azerty220/usart_sans_fil_projet_esc2026_2027/avancee_seances.md

**Séance 1 :**

* cadre du projet fixé avec le client

* définition d'un chef de projet

* lecture des documentations existantes

* mise en place d'un outil de gestion d'information : GitHub

* mise en place d'un outil de messagerie : teams

* Comparaison des solutions proposées (BPSK à 2.44GHz, et ASK à 868MHz) : Avantages, Inconvénients

**Devoirs pour la séance 2 :**

Lire attentivement les documents et être apte à les comprendre

**Séance 2 :**

* Version de KiCad qui sera utilisée : 9.0
* Chaîne de fonctionnement du système établie
* Répartition du travail à faire, création des binômes, affiliation
* Création du planning et d'un diagramme de Gantt sur la globalité du projet

**Devoir pour la séance 3 :**

Trouver les composants nécessaire aux bloc affilié à notre binôme, afin de présenter un bilan de puissance par bloc.

On fera attention aux critères de gain, de prix, de pertes et de bruit thermique pour le choix des composants.

**Séance 3 :**

* Mise en commun des différents composants trouvés
* Statut sur la fréquence utilisée : 868.6MHz
* Commande de composants nécessaires passée : pour tout le projet (pcb suivant également) en prenant en compte les composants que nous avons déjà en stock

**Devoir pour la séance 4 :**

Prendre en compte que nous devons finir le routage du pcb la semaine prochaine et s'avancer sur le schématique en fonction du besoin.

**Séance 4 :**

* Finition des schématiques
* Avancée / Finitions du routage
* Prise en compte des composants passifs présents dans l'école : pour les dimensions pour l'empreinte notamment

**Devoir pour la séance 5 :**

Avoir fini le routage entre temps, l'avoir fait validé, et qu'il ait été envoyé pour construction.

En prévision de la séance 5 : rien !

**Séance 6 :**

* Protocole de test rédigé pour chaque PCB
* Schématique du PCB final fait

**Devoir pour la séance 7 :**

Avoir soudé le PCB et avoir effectué les tests afin de pouvoir modifié le routage du PCB final.

**Séance 7 :**

* écrire ici
