azerty220/usart_sans_fil_projet_esc2026_2027/images/ModASK_ADG918.png

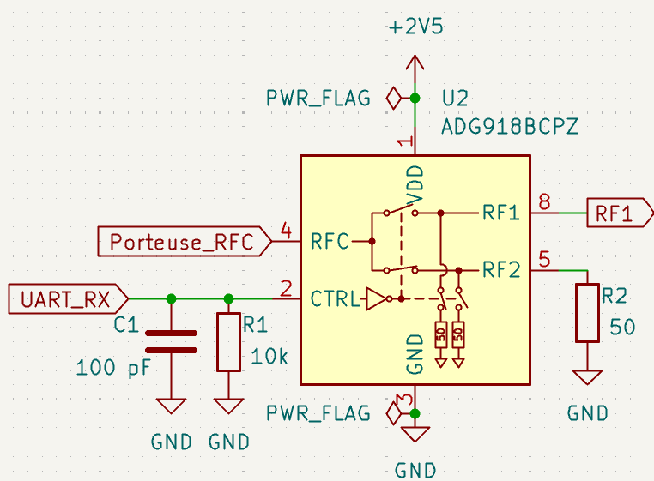
images/ModASK_ADG918.png
