azerty220/usart_sans_fil_projet_esc2026_2027/images/ModASK_PCB_KiCAD.png

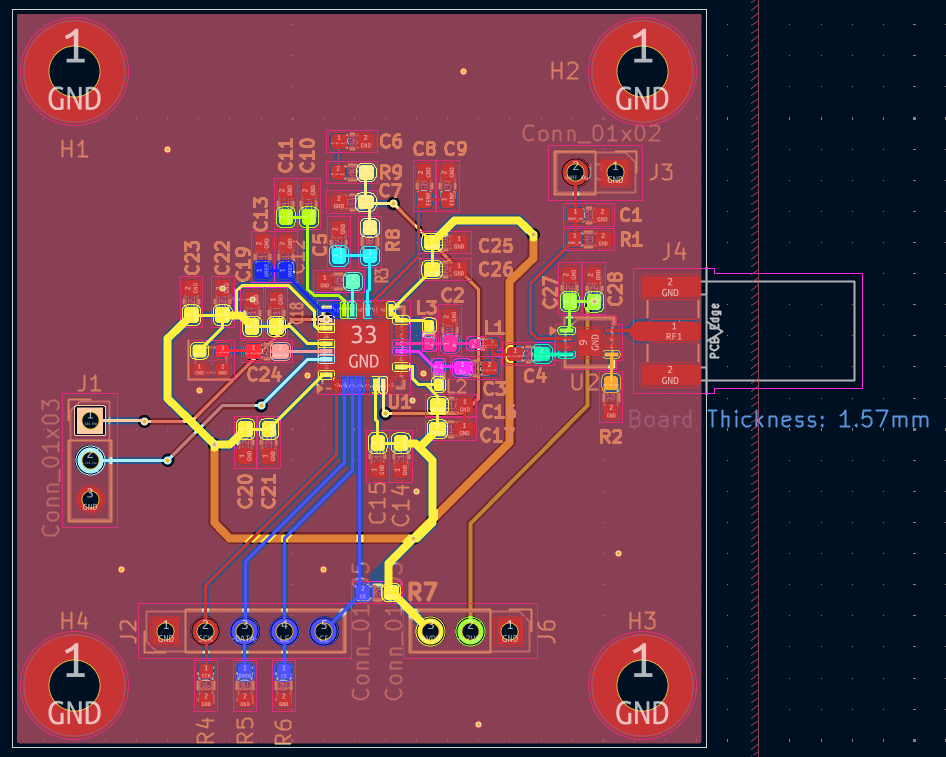
images/ModASK_PCB_KiCAD.png
