azerty220/usart_sans_fil_projet_esc2026_2027/images/ModASK_Table_balun_values.png

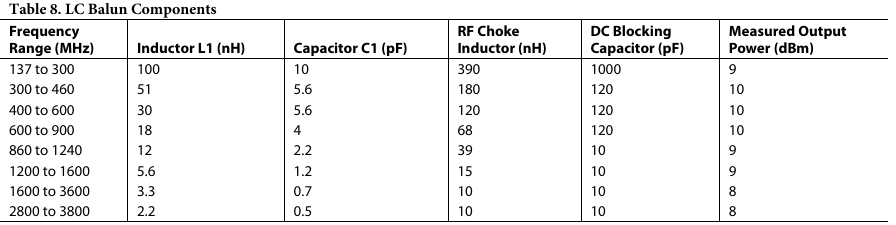
images/ModASK_Table_balun_values.png
