azerty220/usart_sans_fil_projet_esc2026_2027/images/ModASK_Vtune_Cpout.png

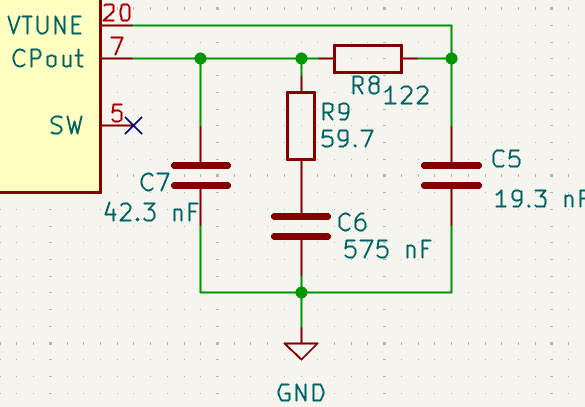
images/ModASK_Vtune_Cpout.png
