azerty220/usart_sans_fil_projet_esc2026_2027/images/Schéma simplifié du projet.png

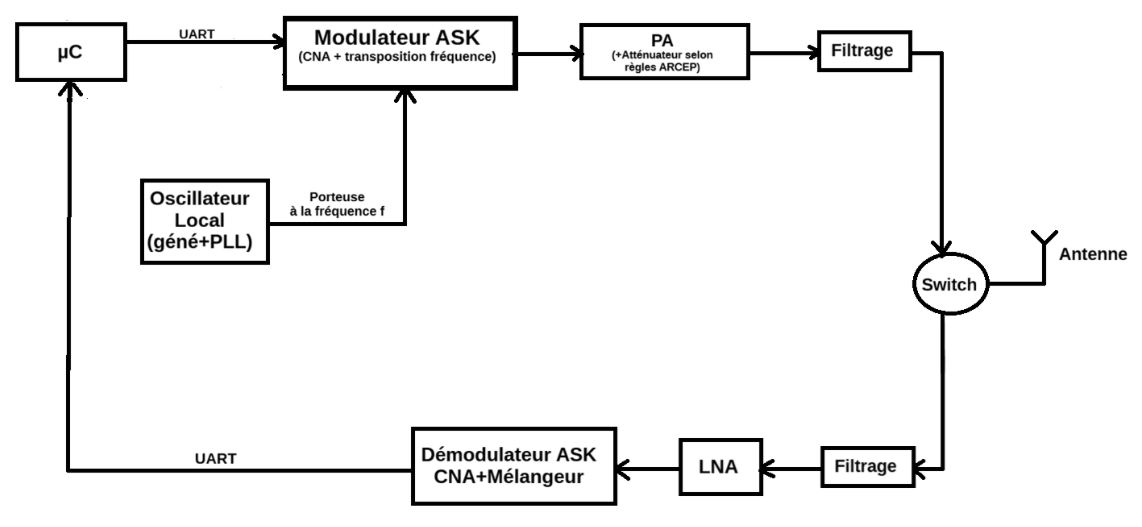
images/Schéma simplifié du projet.png
