azerty220/usart_sans_fil_projet_esc2026_2027/Compta.xlsx

Item | Détails | Quantité | Prix | Total | Commentaire
1. Commande composants | PLL+géné (OL) 584-ADF4350BCPZ | 1 | 18.83€ | 18.83€
 | Démodulateur 584-AD8313ARMZ-R | 1 | 23.32€ | 23.32€
 | Guerrilla RF GRF2070 | 3 | 2.30€ | 6.90€ |  | Budget alloué | 250€
 | Filtres passe bande SF2425E 868.6MHz 198-SF2425E | 5 | 1.16€ | 5.80€ |  | Total projet | 196.88€
 | Frais de port | 1 | 25€ | 25€ |  | Budget restant | 53.115€
 |  |  | Total Item 1 | 79.85€
2. Commande PCBs | PCB Mod ASK+PLL avec stencil | 1 | 9.9858 | 9.9858
 | PCB PA+Filtrage avec stencil | 1 | 10.0748 | 10.0748
 | PCB Switch+Antenne avec stencil | 1 | 9.9858 | 9.9858
 | PCB LNA+Filtrage avec stencil | 1 | 9.9858 | 9.9858
 | PCB Démodulateur avec stencil | 1 | 10.0748 | 10.0748
 | Frais de port | 2 | 33.464 | 66.928
 |  |  | Total Item 2 | 117.035
3. Commande PCB | PCB Final
 | Frais de port |  | 33.464
 |  |  | Total item 3 | 0
