azerty220/usart_sans_fil_projet_esc2026_2027/composants/liste_composants_projet.ods

Composant | Référence | Nb nécessaire | En stock / à commander | Binôme | Prix | Fournisseur | Lien
Machien magique | MMxxx999 | 1 | à commander | Johan / Awa | 0,00 € | Würth | https://magical-machine.com
Switch RF | PE42430MLAB-Z | 1 | En stock | Johan / Awa
antenne drone | 74889100921 | 1 | En stock | Johan / Awa
PLL+géné (OL) | ADF4350BCPZ | 1 | à commander | Julie / Maxence | 18,83 € | Mouser
Démodulateur | Ad8313 | 1 | à commander | Johan / Awa | 24,00 € | Mouser
Antenne PC (WIRL-ACCE HYDRA-1) | 2600130083 | 1 | à commander | Johan / Awa | 0,00 € | Würth
LNA | Guerrilla RF GRF2070 | 3 | à commander | Julie / Rafik | 2,30 € | Mouser
Filtres Passe-bande 868,6MHz | SF2425E / 198-SF2425E | 5 | à commander | Callum / Elise | 1,16 € | Mouser
