azerty220/usart_sans_fil_projet_esc2026_2027/composants/Liste des composants disponibles salle D283 - Feuille 1.ods

Fonction | Référence Fabricant | Lien Mouser | Quantité | Lien Wurth
Boucles à phase asservie - PLL F-N with high performance integrated VCO | ADF4350BCPZ | https://www.mouser.fr/fr/ProductDetail/Analog-Devices/ADF4350BCPZ?qs=BpaRKvA4VqGt2ZHwONikjQ%3D%3D | 1
Démodulateur - Détecteur RF uSOIC 0.1 TO 2.5GHz Détecteur RF/Cntrllr | AD831ARMZ | https://www.mouser.fr/fr/ProductDetail/Analog-Devices/AD8314ARMZ?qs=%2FtpEQrCGXCwYfXULcE%2FB2A%3D%3D | 1
Modulateur ASK - CI commutateurs RF 1GHz 2:1 MUX (50 Ohm Termination) I.C. | ADG918BCPZ-500RL7 | https://www.mouser.fr/fr/ProductDetail/Analog-Devices/ADG918BCPZ-500RL7?qs=BpaRKvA4VqFQVutXSJar%2FA%3D%3D | 5
VCO - Oscillateurs VCO Monolithic Voltage Controlled Oscillator | MAX2622EUA+ | https://www.mouser.fr/fr/ProductDetail/Analog-Devices-Maxim-Integrated/MAX2622EUA%2B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 | 2
Condensateurs céramique multicouches MLCC - CMS 2GHz-4GHz 100V S Band | BC08208408DXBAJ | https://www.mouser.fr/fr/ProductDetail/Vishay/BC08208408DXBAJ?qs=Znm5pLBrcAL97FjIapAbNw%3D%3D | 83
PA (Power Amplifier) - Amplificateur RF 851-894MHz Gn 36.5dB OP1dB 30.8dBm | SKY66185-11 | https://www.mouser.fr/fr/ProductDetail/Skyworks-Solutions-Inc/SKY66185-11?qs=VxEzYtM1yldMn8MAOsOp7g%3D%3D | 2
Antenne - ANTENNA 2.4GHZ CORNER 140MM SMA | AMB1926 | https://www.mouser.be/fr/ProductDetail/Wurth-Elektronik/2600130021 (https://www.mouser.fr/fr/ProductDetail/Skyworks-Solutions-Inc/SKY66185-11?qs=VxEzYtM1yldMn8MAOsOp7g%3D%3D) | 1 | https://www.digikey.fr/en/products/detail/w%C3%BCrth-elektronik/AMB1926/8258139
Atténuateur - RF Attenuators 6dB 0 Hz ~ 3 GHz 50 Ohms 125mW 1206 (3216 Metric) | PAT1632-C-6DB-T1 | https://www.mouser.fr/fr/ProductDetail/Susumu/PAT1632-C-6DB-T1?qs=wnTfsH77Xs6rJxxbm0fa2w%3D%3D | 3 | https://www.digikey.fr/en/products/detail/susumu/PAT1632-C-6DB-T1/5975823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
PA (Power Amplifier) - Amplificateur RF .1-6.0GHz InGaP HBT Sm Sig Gain 16dB | SKY65014-70LF | https://www.mouser.fr/fr/ProductDetail/Skyworks-Solutions-Inc/SKY65014-70LF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 | 4
LNA - Amplificateur RF 0.6-4.2 GHz Ultra-LNA | QPL9057TR7 | https://www.mouser.fr/fr/ProductDetail/Qorvo/QPL9057TR7?qs=PqoDHHvF648aNfv0Ctpg5A%3D%3D | 4
OL - Oscillateurs VCO VCO SMT w/Buffer amp, 2.25 - 2.5 GHz | HMC385LP4ETR | https://www.mouser.fr/fr/ProductDetail/Analog-Devices/HMC385LP4ETR?qs=pceeu5JH%2FH%2FWo0fp8A7gpg%3D%3D | 4
MIX - Mixage RF DBL BAL MIX / SURF MT / RoHS | ADE-3G+ | https://www.mouser.fr/fr/ProductDetail/Mini-Circuits/ADE-3G%2b?qs=xZ%2FP%252Ba9zWqaih72O7p1wPA%3D%3D | 4
OL - Oscillateurs VCO 2400-2400MHz -40C to 85C | CVCO55CC-2400-2400 | https://www.mouser.fr/fr/ProductDetail/Crystek-Corporation/CVCO55CC-2400-2400?qs=4zFPArRKzl55cc50XS6Y7Q%3D%3D | 4
3.0V to 5.5 V - Circuit intégré d'interface RS-232 3.0V to 5.5V, Low-Power, up to 1Mbps, Tr | MAX3232ESE+T | https://www.mouser.fr/fr/ProductDetail/Analog-Devices-Maxim-Integrated/MAX3232ESE%2BT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 | 10
Filtre - Conditionnement de signaux 1.4 mm x 1.1 mm - 20 C to + 75 C 2.44175 GHz 2 dB 83.5 MHz 3.5 V 50 Ohms | B39242B9413K610 | https://www.mouser.fr/fr/ProductDetail/RF360/B39242B9413K610?qs=AKDv8POSxR1xnWOVVPKw7A%3D%3D | 7
Condensateurs céramique multicouches MLC - Condensateurs céramique multicouches MLCC - CMS 0.047 uF 630 VDC 10% 1210 X7T | GR332DD72J473KW01L | https://www.mouser.fr/fr/ProductDetail/Murata-Electronics/GR332DD72J473KW01L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 | 10
Filtre - Conditionnement de signaux DBP.868.U.A.30 Dielectric Band Pass Filter for 868MHz | DBP.868.U.A.30 | https://www.mouser.fr/fr/ProductDetail/Taoglas/DBP.868.U.A.30?qs=MLItCLRbWsxZm5scDvQavg%3D%3D | 1
Atténuateur | HMC346AMS8GETR | https://www.mouser.fr/fr/ProductDetail/Analog-Devices/HMC346AMS8GETR?qs=5aG0NVq1C4wB%2Fd11tx7%252Bpw%3D%3D | 2
Quartz 26MHz - Oscillateurs TCXO MultiVolt TCXO,26MHz,+/-500ppb,1.7V 3.465V,2.0 mA,-30 C 85 C, 2.00mm x 1.60mm | ECS-TXO-20CSMV-AC-260-AY-TR | https://www.mouser.fr/fr/ProductDetail/ECS/ECS-TXO-20CSMV-260-AY-TR?qs=Cb2nCFKsA8q4u1W%252BdBvDzQ%3D%3D | 3
Quartz 25MHz - Oscillateurs TCXO XTAL OSC TCXO 25MHz CMOS | ATX-H11-F-25.000MHz-F25-T | https://www.mouser.fr/fr/ProductDetail/ABRACON/ATX-H11-F-25.000MHz-F25-T?qs=vvQtp7zwQdNp90v3eF%2F7eg%3D%3D | 4
Switch - CI commutateurs RF DC-3.0GHz ISO 22dB IL <.3dB @ 2.4GHz | MASWSS0115TR-3000 | https://www.mouser.fr/fr/ProductDetail/MACOM/MASWSS0115TR-3000?qs=3Wmz%2FrCSAaEflvnPFG8Leg%3D%3D | 4
Module - Émetteur-récepteur RF Low-Power Sub-1GHz R F Transceiver A 595 A 595-CC1101RGPR | CC1101RGP | https://www.mouser.fr/fr/ProductDetail/Texas-Instruments/CC1101RGP?qs=OHhYoCux73laNhcVQ4PFrw%3D%3D | 2
Résistances ajustables - SMD 4mm 10Kohms 10% Square Cermet Sealed | 3224W-1-103G | https://www.mouser.fr/fr/ProductDetail/Bourns/3224W-1-103G?qs=tEaODSGlU8MrZGpCN6zqBQ%3D%3D | 2
Switch - CI commutateurs RF SP3T, Low IL, Reflective, 50ohm RF Switch | PE42430MLAB-Z | https://www.mouser.fr/fr/ProductDetail/pSemi/PE42430MLAB-Z?qs=iw0hurA%2FaD37L0LfLBRi4Q%3D%3D | 4
LNA - Amplificateur RF Low Noise Amplifier 0.15 - 6 GHz | MAAL-011207-TR3000 | https://www.mouser.fr/fr/ProductDetail/MACOM/MAAL-011207-TR3000?qs=rQFj71Wb1eUM1YfhtamsxQ%3D%3D | 3
Inducteurs RF - CMS IFCB-0402 .0082 3.7% ER E3 | IFCB0402ER8N2S | https://www.mouser.com/ProductDetail/Vishay-Dale/IFCB0402ER8N2S?qs=IFXZK9YKOtYBs1cy8OBmcA%3D%3D | 49
Inducteurs RF - CMS 1005 140nH Unshld 5% 630mA 260mOhms | 0402AF-141XJLW | https://www.mouser.fr/fr/ProductDetail/Coilcraft/0402AF-141XJLW?qs=JVZp5BaCFzgnytl%252BpX4NdQ%3D%3D | 9
Antenne Céramique - WE-MCA Multilayer Chip Antenna | 7488960245 |  | 1 | https://www.we-online.com/en/components/products/WE-MCA?sq=7488960245#7488960245
Inductance - WE-KI SMT Wire Wound Ceramic Inductor | 744761211A |  | 20 | https://www.we-online.com/en/components/products/WE-KI?sq=744761211A#744761211A
