azerty220/usart_sans_fil_projet_esc2026_2027/composants/commande_composant.ods

Sheet: Mouser
Mouser |  |  |  |  | Envoyez un seul fichier par mail!
Pos | I | P | Art | Désignation | Qté commandée | UA | Date Livraison | Prix unitaire | Devise | Q | Grpe | Div
10 | Z |  |  | PLL+géné (OL) 584-ADF4350BCPZ | 1 | PC | 16.10.2026 | 18.83 | EUR | PC | TA.01
20 | Z |  |  | Démodulateur 584-AD8313ARMZ-R | 1 | PC | 16.10.2026 | 23.32 | EUR | PC | TA.01
30 | Z |  |  | Frais de port | 1 | PC | 16.10.2026 | 25.00 | EUR | PC | TA.01
40 | Z |  |  | Guerrilla RF GRF2070 | 3 | PC | 16.10.2026 | 2.30 | EUR | PC | TA.01
50 | Z |  |  | Filtres passe bande SF2425E 868.6MHz 198-SF2425E | 5 | PC | 16.10.2026 | 1.16 | EUR | PC | TA.01
60 | Z |  |  |  |  | PC |  |  | EUR | PC | TA.01
70 | Z |  |  |  |  | PC |  |  | EUR | PC | TA.01
80 | Z |  |  |  |  | PC |  |  | EUR | PC | TA.01
90 | Z |  |  |  |  | PC |  |  | EUR | PC | TA.01
100 | Z |  |  |  |  | PC |  |  | EUR | PC | TA.01
110 | Z |  |  |  |  | PC |  |  | EUR | PC | TA.01
120 | Z |  |  |  |  | PC |  |  | EUR | PC | TA.01
130 | Z |  |  |  |  | PC |  |  | EUR | PC | TA.01
140 | Z |  |  |  |  | PC |  |  | EUR | PC | TA.01
150 | Z |  |  |  |  | PC |  |  | EUR | PC | TA.01
160 | Z |  |  |  |  | PC |  |  | EUR | PC | TA.01
170 | Z |  |  |  |  | PC |  |  | EUR | PC | TA.01
180 | Z |  |  |  |  | PC |  |  | EUR | PC | TA.01
190 | Z |  |  |  |  | PC |  |  | EUR | PC | TA.01
MODE d'EMPLOI et CODE erreurs Version 19
1: indiquez le fournisseur ligne 1
2:remplissez pour chaque ligne commandée les 4 champs en rouge selon les règles suivantes:
 | Art
 |  |  | 2.1 | Ne mettez rien ici tout comme dans P: remplissez les zones rouges (et pas ailleurs)
 | Désignation
 |  |  | 2.2 | Ne dépassez pas les 40 caractères: il seront automatiquement effacés lors de la recopie
 |  |  | 2.3 | Mettre une courte descritption suiivi du code commande du fournisseur
 |  |  | 2.4 | Pour RS et Farnell : mettre le code commande RS ou Farnell (7 à 9 chiffres) (et pas la référence constructeur) après la courte description
 |  |  | 2.5 | Exemple: Condensateur 1uF 0805 125-4857
 | Qté commandée
 |  |  | 2.6 | C'est le nombre d'unités correspondant au prix unitaire
 |  |  | 2.7 | Attention il y a des pièges
 |  |  | 2.8 | avec RS par exemple on vous demande parfois de commander par lot de 5 par exemple
 |  |  | 2.9 | si vous commandez 1 lot : le nombre d'unité est alors 5 pour 1 lot et non 1
 | date
 |  |  | 2.10 | Pour la date: mettre la de date dans une semaine
 |  |  | 2.11 | La mettre au format JJ.MM.AAAA
 |  |  | 2.13 | Bien utiliser les points comme séparateur
 | prix unitaire
 |  |  | 2.14 | Le prix est le prix HT (sans la TVA 20%) en euros d'une unité
 |  |  | 2.15 | arrondi au centime supérieur (0.012 euros devient 0.02!)
 |  |  | 2.16 | avec pour séparateur le point
 |  |  | 2.17 | n'utilisez pas le symbole euros d'excel
3: frais de port
 |  |  | 3.1 | ajoutez une ligne pour les frais de port
 |  |  | 3.2 | dont la désignation est "frais de port"
 |  |  | 3.3 | pas de frais de port à mettre pour RS ou Farnell
 |  |  | 3.4 | Renseignez vous pour connaître les frais de port
4: conseils complémentaires
 |  |  | 4.1 | Ne modifier que les 4 champs en rouge
 |  |  | 4.2 | Ne pas modifier le document sinon cela n'a plus aucun intérêt
 |  |  | 4.3 | Mettez les références dans le même ordre que celui de la commande
 |  |  | 4.4 | Vérifier bien sur les sites les références et les prix!
 |  |  | 4.5 | N'oubliez pas les frais de port!: ajoutez une ligne pour les mentionner
5: sauvegardez le fichier au format xls

Sheet: Würth
Würth |  |  |  |  | Envoyez un seul fichier par mail!
Pos | I | P | Art | Désignation | Qté commandée | UA | Date Livraison | Prix unitaire | Devise | Q | Grpe | Div
10 | Z |  |  | Antenne(WIRL-ACCE HYDRA-1) 2600130083 | 1 | PC | 16.10.2026 | 0.00 | EUR | PC | TA.01
20 | Z |  |  |  |  | PC |  |  | EUR | PC | TA.01
30 | Z |  |  |  |  | PC |  |  | EUR | PC | TA.01
40 | Z |  |  |  |  | PC |  |  | EUR | PC | TA.01
50 | Z |  |  |  |  | PC |  |  | EUR | PC | TA.01
60 | Z |  |  |  |  | PC |  |  | EUR | PC | TA.01
70 | Z |  |  |  |  | PC |  |  | EUR | PC | TA.01
80 | Z |  |  |  |  | PC |  |  | EUR | PC | TA.01
90 | Z |  |  |  |  | PC |  |  | EUR | PC | TA.01
100 | Z |  |  |  |  | PC |  |  | EUR | PC | TA.01
110 | Z |  |  |  |  | PC |  |  | EUR | PC | TA.01
120 | Z |  |  |  |  | PC |  |  | EUR | PC | TA.01
130 | Z |  |  |  |  | PC |  |  | EUR | PC | TA.01
140 | Z |  |  |  |  | PC |  |  | EUR | PC | TA.01
150 | Z |  |  |  |  | PC |  |  | EUR | PC | TA.01
160 | Z |  |  |  |  | PC |  |  | EUR | PC | TA.01
170 | Z |  |  |  |  | PC |  |  | EUR | PC | TA.01
180 | Z |  |  |  |  | PC |  |  | EUR | PC | TA.01
190 | Z |  |  |  |  | PC |  |  | EUR | PC | TA.01
MODE d'EMPLOI et CODE erreurs Version 19
1: indiquez le fournisseur ligne 1
2:remplissez pour chaque ligne commandée les 4 champs en rouge selon les règles suivantes:
 | Art
 |  |  | 2.1 | Ne mettez rien ici tout comme dans P: remplissez les zones rouges (et pas ailleurs)
 | Désignation
 |  |  | 2.2 | Ne dépassez pas les 40 caractères: il seront automatiquement effacés lors de la recopie
 |  |  | 2.3 | Mettre une courte descritption suiivi du code commande du fournisseur
 |  |  | 2.4 | Pour RS et Farnell : mettre le code commande RS ou Farnell (7 à 9 chiffres) (et pas la référence constructeur) après la courte description
 |  |  | 2.5 | Exemple: Condensateur 1uF 0805 125-4857
 | Qté commandée
 |  |  | 2.6 | C'est le nombre d'unités correspondant au prix unitaire
 |  |  | 2.7 | Attention il y a des pièges
 |  |  | 2.8 | avec RS par exemple on vous demande parfois de commander par lot de 5 par exemple
 |  |  | 2.9 | si vous commandez 1 lot : le nombre d'unité est alors 5 pour 1 lot et non 1
 | date
 |  |  | 2.10 | Pour la date: mettre la de date dans une semaine
 |  |  | 2.11 | La mettre au format JJ.MM.AAAA
 |  |  | 2.13 | Bien utiliser les points comme séparateur
 | prix unitaire
 |  |  | 2.14 | Le prix est le prix HT (sans la TVA 20%) en euros d'une unité
 |  |  | 2.15 | arrondi au centime supérieur (0.012 euros devient 0.02!)
 |  |  | 2.16 | avec pour séparateur le point
 |  |  | 2.17 | n'utilisez pas le symbole euros d'excel
3: frais de port
 |  |  | 3.1 | ajoutez une ligne pour les frais de port
 |  |  | 3.2 | dont la désignation est "frais de port"
 |  |  | 3.3 | pas de frais de port à mettre pour RS ou Farnell
 |  |  | 3.4 | Renseignez vous pour connaître les frais de port
4: conseils complémentaires
 |  |  | 4.1 | Ne modifier que les 4 champs en rouge
 |  |  | 4.2 | Ne pas modifier le document sinon cela n'a plus aucun intérêt
 |  |  | 4.3 | Mettez les références dans le même ordre que celui de la commande
 |  |  | 4.4 | Vérifier bien sur les sites les références et les prix!
 |  |  | 4.5 | N'oubliez pas les frais de port!: ajoutez une ligne pour les mentionner
5: sauvegardez le fichier au format xls
