azerty220/usart_sans_fil_projet_esc2026_2027/PCB2/gros_pcb_commun/gros_pcb_commun.kicad_pcb

## KiCad design PCB2/gros_pcb_commun/gros_pcb_commun.kicad_pcb (2026-11-12)

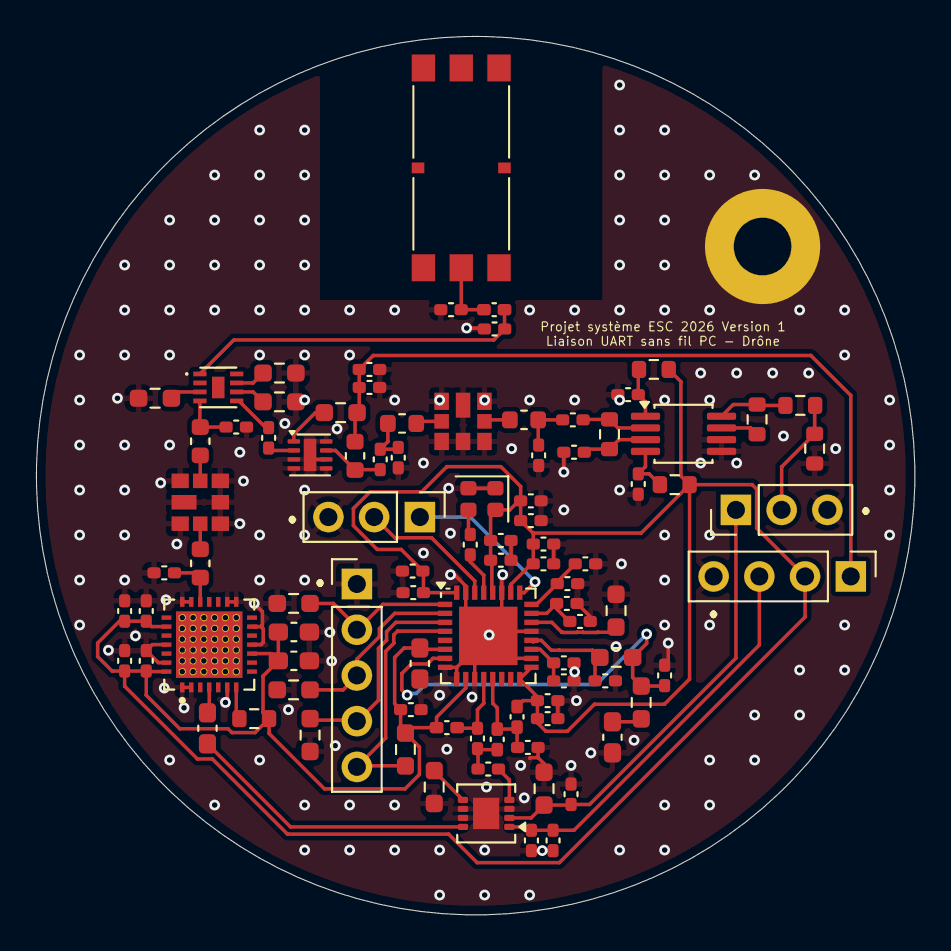
[picture p59: board gros_pcb_commun.kicad_pcb from above]

Board: 2 copper layers, 48.8 x 48.8 mm, 93 parts (0 on the bottom side), 52 nets.

Parts:
AE1: Antenna; AE_Wurth_WE-MCA_7488910092
C1, C3, C5, C7, C9: 100 nF; C_0402_1005Metric_Pad0.74x0.62mm_HandSolder
C2, C4, C6, C10, C13, C15, C17, C27: 10 pF; C_0402_1005Metric_Pad0.74x0.62mm_HandSolder
C8: 10 pF; C_0603_1608Metric_Pad1.08x0.95mm_HandSolder
C11: 1 uF; C_0402_1005Metric_Pad0.74x0.62mm_HandSolder
C12, C14, C16, C18, C28, C42, C43: 0.1 uF; C_0402_1005Metric_Pad0.74x0.62mm_HandSolder
C19: 1 nF; C_0402_1005Metric_Pad0.74x0.62mm_HandSolder
C20, C21: 4 nF; C_0402_1005Metric_Pad0.74x0.62mm_HandSolder
C22: 120 pF; C_0402_1005Metric_Pad0.74x0.62mm_HandSolder
C23: 42.3 nF; C_0402_1005Metric_Pad0.74x0.62mm_HandSolder
C24: 575 nF; C_0603_1608Metric_Pad1.08x0.95mm_HandSolder
C25: 19.3 nF; C_0402_1005Metric_Pad0.74x0.62mm_HandSolder
C26: 100 pF; C_0402_1005Metric_Pad0.74x0.62mm_HandSolder
C29, C32, C35, C36: 0.1u; C_0402_1005Metric_Pad0.74x0.62mm_HandSolder
C30: 2.7p; C_0402_1005Metric_Pad0.74x0.62mm_HandSolder
C31: 33p; C_0603_1608Metric_Pad1.08x0.95mm_HandSolder
C33, C37: 10u; C_0603_1608Metric_Pad1.08x0.95mm_HandSolder
C34: 3.5p; C_0402_1005Metric_Pad0.74x0.62mm_HandSolder
C38: 3.9pF; C_0402_1005Metric_Pad0.74x0.62mm_HandSolder
C39: 3.3pF; C_0402_1005Metric_Pad0.74x0.62mm_HandSolder
C40, C41: 680 pF; C_0402_1005Metric_Pad0.74x0.62mm_HandSolder
C44: 47pF; C_0402_1005Metric_Pad0.74x0.62mm_HandSolder
C45: 4.7pF; C_0402_1005Metric_Pad0.74x0.62mm_HandSolder
C46: 100nF; C_0402_1005Metric_Pad0.74x0.62mm_HandSolder
C47: 100pF; C_0402_1005Metric_Pad0.74x0.62mm_HandSolder
C48: 2,7pF; C_0402_1005Metric_Pad0.74x0.62mm_HandSolder
C49: 3,5pF; C_0402_1005Metric_Pad0.74x0.62mm_HandSolder
FL1: SF2425E
H3: MountingHole_Pad; MountingHole_3.2mm_M3_Pad
J1: Conn_01x03_Pin; PinHeader_1x03_P2.54mm_Vertical
J2: Conn_01x04_Pin; PinHeader_1x04_P2.54mm_Vertical
J3: Conn_01x05; PinHeader_1x05_P2.54mm_Vertical
J4: Conn_01x03; PinHeader_1x03_P2.54mm_Vertical
L1: 68 nH; L_0402_1005Metric_Pad0.77x0.64mm_HandSolder
L2, L3: 18 nH; L_0402_1005Metric_Pad0.77x0.64mm_HandSolder
L4, L5: 24n; L_0603_1608Metric
L6: 12nH; L_0402_1005Metric_Pad0.77x0.64mm_HandSolder
L7, L8, L9: 22nH; L_0603_1608Metric
R1, R2, R3, R5, R8, R11, R12, R13: 10k; R_0603_1608Metric_Pad0.98x0.95mm_HandSolder
R4: 5.1 k; R_0603_1608Metric_Pad0.98x0.95mm_HandSolder
R6: 59.7; R_0603_1608Metric_Pad0.98x0.95mm_HandSolder
R7: 122; R_0603_1608Metric_Pad0.98x0.95mm_HandSolder
R9: 50; R_0603_1608Metric_Pad0.98x0.95mm_HandSolder
R10: 5k1; R_0603_1608Metric
R14, R17: 10; R_0603_1608Metric
R15: 53,6; R_0603_1608Metric
R16: 0; R_0603_1608Metric
R18: 910; R_0603_1608Metric_Pad0.98x0.95mm_HandSolder
RL1: 1M; R_0603_1608Metric
Rprot1: 500; R_0603_1608Metric
SF1: SF2425E
U1: ADF4350; LFCSP-32-1EP_5x5mm_P0.5mm_EP3.25x3.25mm
U2: ADG918BCPZ; LFCSP-8-1EP_3x3mm_P0.5mm_EP1.45x1.74mm
U3: SKY66185-11; IC_SKY66185-11
U4: SON50P200X200X60-9N160X90
U5: AD8313xRM; MSOP-8_3x3mm_P0.65mm
U6: GRF2070; DFN-8-2x2mm_P0.7mm
Y1: ECS-TXO-20CSMV-AC-260-AY-TR; Oscillator_SMD_SiT_PQFN-4Pin_2.0x1.6mm

Connections:
+2V5: C27.1, C28.1, J2.3, U2.1 (VDD)
+5V: C46.1, C47.1, J2.1, L7.1, R18.1
A+: C20.1, L2.2, U1.12 (RF_OUT_A+)
A-: C21.1, L1.2, L3.2, U1.13 (RF_OUT_A-)
AVDD: C1.2, C2.2, C3.2, C4.2, C5.2, C6.2, C7.2, C8.2, C9.2, C10.2, C11.1, C12.1, C29.2, C32.2, C33.2, C35.1, C36.1, C37.1, J2.2, L1.1, L2.1, R2.1, R10.1, R14.1, R17.2, U1.6 (Vp), U1.10 (AVDD), U1.16 (VVCO), U1.17 (VVCO), U1.26 (PDB_RF), U1.28 (DVDD), U1.32 (SDVDD), U3.10 (VBIAS), U3.23 (VCC3), U3.28 (VCC1), Y1.4 (VDD)
CE: J3.5, R2.2, U1.4 (CE)
DATA: J3.3, R3.1, U1.2 (DATA)
FiltreIN: C30.1, L4.1, U3.19 (RFOUT)
GND: C1.1, C2.1, C3.1, C4.1, C5.1, C6.1, C7.1, C8.1, C9.1, C10.1, C11.2, C12.2, C13.2, C14.2, C15.2, C16.2, C17.2, C18.2, C21.2, C23.2, C24.2, C25.2, C26.2, C27.2, C28.2, C29.1, C30.2, C32.1, C33.1, C34.2, C35.2, C36.2, C37.2, C38.2, C39.2, C41.1, C42.2, C43.1, C46.2, C47.2, C48.2, C49.1, FL1.1 (IN_GND), FL1.3 (GND), FL1.4 (GND), FL1.5 (OUT_GND), FL1.7 (GND), FL1.8 (GND), H3.1, J1.3, J2.4, J3.1, J4.3, R1.2, R3.2, R4.1, R5.2, R8.2, R9.2, R11.2, R12.2, R13.2, RL1.1, SF1.1 (IN_GND), SF1.3 (GND), SF1.4 (GND), SF1.5 (OUT_GND), SF1.7 (GND), SF1.8 (GND), U1.8 (CPGND), U1.9 (AGND), U1.11 (AGNDVCO), U1.18 (AGNDVCO), U1.21 (AGNDVCO), U1.27 (DGND), U1.31 (SDGND), U1.33 (EP), U2.3 (GND), U2.6 (GND), U2.7 (GND), U2.9 (GND), U3.1 (GND), U3.2 (GND), U3.6 (GND), U3.11 (GND), U3.13 (GND), U3.15 (GND), U3.16 (GND), U3.20 (GND), U3.21 (GND), U3.25 (GND), U3.27 (GND), U5.5 (PWDN), U5.6 (COMM), U6.3 (GND), U6.4 (GND), U6.5 (GND), U6.6 (GND), U6.8 (GND), U6.9 (EP), Y1.1 (GROUND_1), Y1.2 (GROUND_2)
LE: J3.4, R1.1, U1.3 (LE)
unnamed: AE1.2 (A), C39.1, L6.2
unnamed: C20.2, C22.1, L3.1
unnamed: C24.1, R6.2
unnamed: C42.1, R14.2, U5.1 (VPOS)
unnamed: C43.2, R17.1, U5.4 (VPOS)
unnamed: C45.2, C48.1, L8.1
unnamed: FL1.2 (IN), L8.2
unnamed: FL1.6 (OUT), L9.1
unnamed: J4.1, U1.25 (LD)
unnamed: J4.2, U1.30 (MUXOUT)
unnamed: L4.2, SF1.2 (IN)
unnamed: L5.1, SF1.6 (OUT)
unnamed: C23.1, R6.1, R7.2, U1.7 (CPout)
unnamed: R4.2, U1.22 (RSET)
unnamed: C25.1, R7.1, U1.20 (VTUNE)
unnamed: R9.1, U2.5 (RF2)
unnamed: C31.2, U3.4 (RFIN)
unnamed: R10.2, U3.7 (~VEN)
unnamed: C38.1, L6.1, U4.1 (RFC)
unnamed: R11.1, U4.3 (V1)
unnamed: R12.1, U4.6 (V2)
unnamed: R13.1, U4.7 (V3)
unnamed: C40.2, R15.1, U5.2 (INHI)
unnamed: C41.2, R15.2, U5.3 (INLO)
unnamed: R16.1, Rprot1.1, U5.8 (VOUT)
unnamed: R16.2, U5.7 (VSET)
unnamed: C44.2, U6.2 (RF_IN)
unnamed: C45.1, L7.2, U6.7 (RF_OUT/VDD)
unnamed: R18.2, U6.1 (VENABLE)
unnamed: C19.1, Y1.3 (OUTPUT)
Porteuse_RFC: C22.2, U2.4 (RFC)
REFIN: C19.2, U1.29 (REFIN)
SCK: J3.2, R5.1, U1.1 (CLK)
TEMP: C13.1, C14.1, U1.19 (TEMP)
VCOM: C15.1, C16.1, U1.23 (VCOM)
VREF: C17.1, C18.1, U1.24 (VREF)
sig0: C26.1, J1.1, R8.1, U2.2 (CTRL)
sig1: C31.1, U2.8 (RF1)
sig2: C34.1, L5.2, U4.4 (RF1)
sig3: C44.1, U4.5 (RF2)
sig4: C40.1, C49.2, L9.2
sig5: J1.2, RL1.2, Rprot1.2
