azerty220/usart_sans_fil_projet_esc2026_2027/PCB1/LNA_Filtre/V9.0/LNA_GRF2070.kicad_pcb

## KiCad design PCB1/LNA_Filtre/V9.0/LNA_GRF2070.kicad_pcb (2026-10-22)

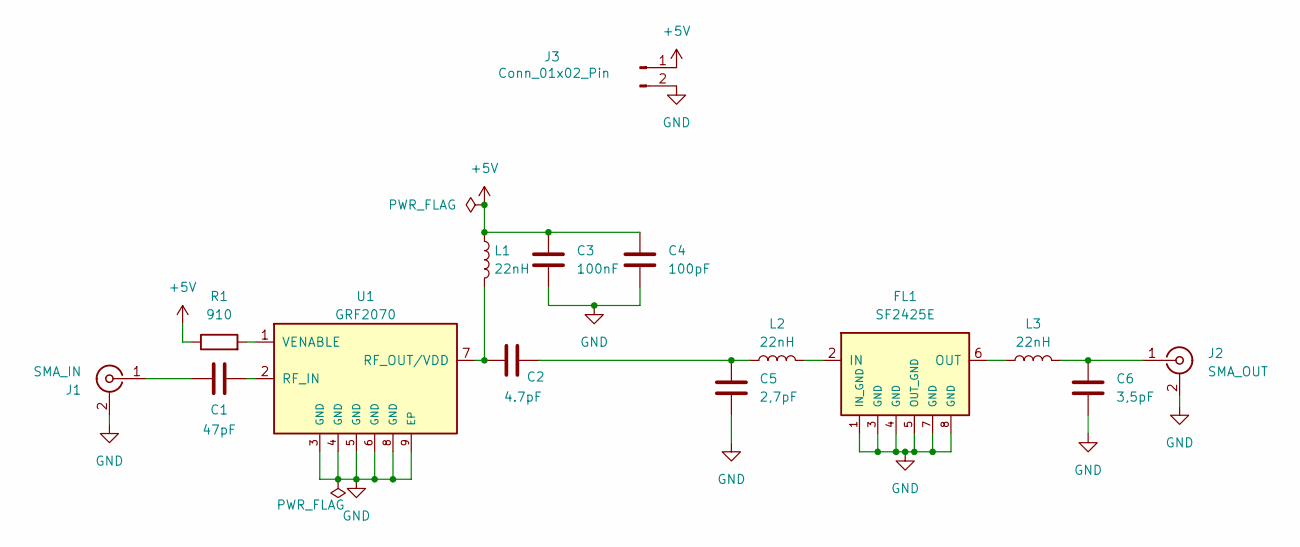
[picture p60: schematic LNA_GRF2070.kicad_sch]

Parts:
C1: 47pF; C_0603_1608Metric
C2: 4.7pF; C_0603_1608Metric
C3: 100nF; C_0603_1608Metric
C4: 100pF; C_0603_1608Metric
C5: 2,7pF; C_0603_1608Metric
C6: 3,5pF; C_0603_1608Metric
FL1: SF2425E
J1: SMA_IN; SMA_Samtec_SMA-J-P-H-ST-EM1_EdgeMount
J2: SMA_OUT; SMA_Samtec_SMA-J-P-H-ST-EM1_EdgeMount
J3: Conn_01x02_Pin; PinHeader_1x02_P2.54mm_Vertical
L1, L2, L3: 22nH; L_0603_1608Metric
R1: 910; R_0603_1608Metric_Pad0.98x0.95mm_HandSolder
U1: GRF2070; WDFN-8-1EP_2x2.2mm_P0.5mm_EP0.80x0.54

Connections:
+5V: C3.1, C4.1, J3.1, L1.1, R1.1
GND: C3.2, C4.2, C5.2, C6.1, FL1.1 (IN_GND), FL1.3 (GND), FL1.4 (GND), FL1.5 (OUT_GND), FL1.7 (GND), FL1.8 (GND), J1.2 (Ext), J2.2 (Ext), J3.2, U1.3 (GND), U1.4 (GND), U1.5 (GND), U1.6 (GND), U1.8 (GND), U1.9 (EP)
unnamed: C2.2, C5.1, L2.1
unnamed: FL1.2 (IN), L2.2
unnamed: FL1.6 (OUT), L3.1
unnamed: C1.1, J1.1 (In)
unnamed: C6.2, J2.1 (In), L3.2
unnamed: C1.2, U1.2 (RF_IN)
unnamed: C2.1, L1.2, U1.7 (RF_OUT/VDD)
unnamed: R1.2, U1.1 (VENABLE)

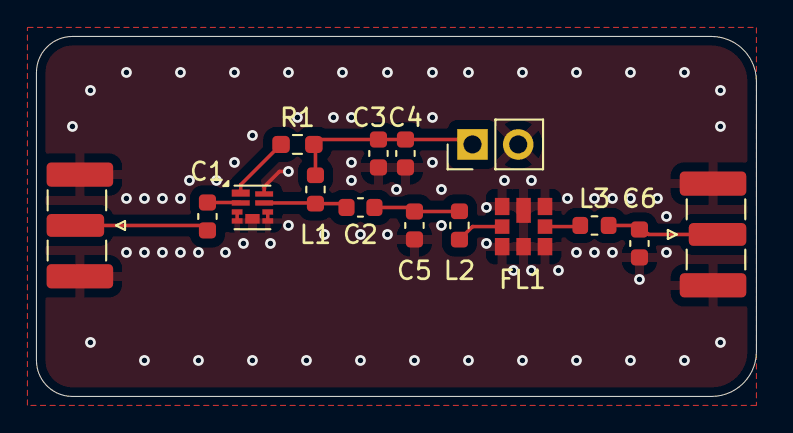
[picture p61: board LNA_GRF2070.kicad_pcb from above]

Board: 2 copper layers, 40.0 x 20.0 mm, 15 parts (0 on the bottom side), 10 nets.
