azerty220/usart_sans_fil_projet_esc2026_2027/PCB1/demodulateur/Démodulateur USART ASK-2026-10-17_155308/Démodulateur USART ASK.kicad_pcb

## KiCad design PCB1/demodulateur/Démodulateur USART ASK-2026-10-17_155308/Démodulateur USART ASK.kicad_pcb (2026-10-22)

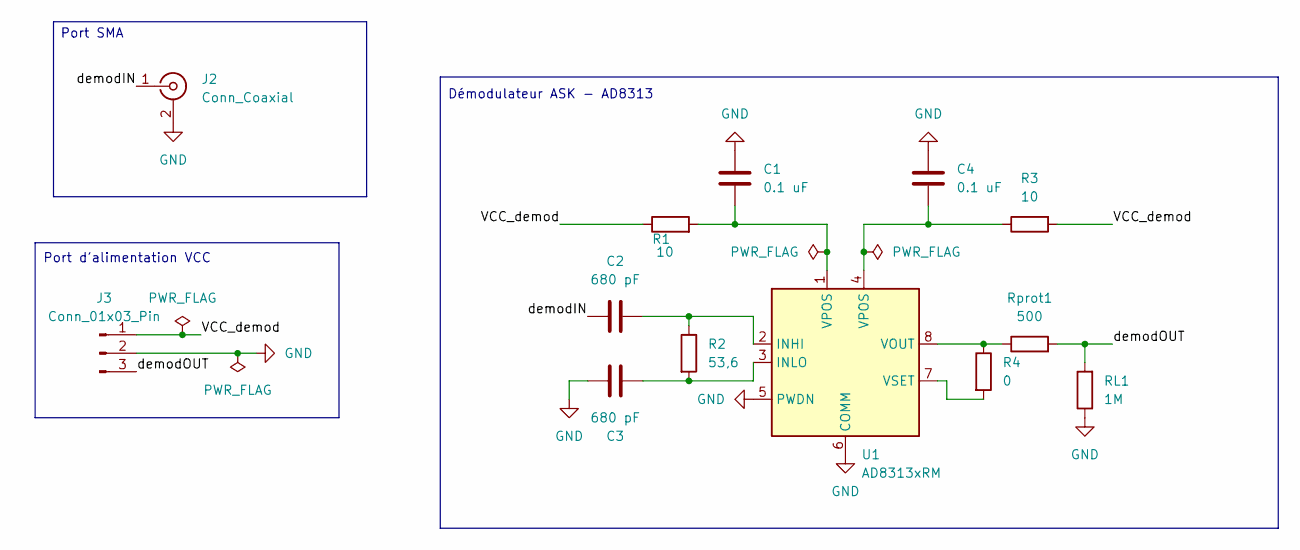
[picture p62: schematic Démodulateur USART ASK.kicad_sch]

Parts:
C1, C4: 0.1 uF; C_0603_1608Metric
C2, C3: 680 pF; C_0603_1608Metric
J2: Conn_Coaxial; SMA_Samtec_SMA-J-P-H-ST-EM1_EdgeMount
J3: Conn_01x03_Pin; PinHeader_1x03_P2.54mm_Vertical
R1, R3: 10; R_0603_1608Metric
R2: 53,6; R_0603_1608Metric
R4: 0; R_0603_1608Metric
RL1: 1M; R_0603_1608Metric
Rprot1: 500; R_0603_1608Metric
U1: AD8313xRM; MSOP-8_3x3mm_P0.65mm

Connections:
/VCC_demod: J3.1, R1.1, R3.2
/demodIN: C2.1, J2.1 (In)
/demodOUT: J3.3, RL1.2, Rprot1.2
GND: C1.2, C3.1, C4.1, J2.2 (Ext), J3.2, RL1.1, U1.5 (PWDN), U1.6 (COMM)
unnamed: C1.1, R1.2, U1.1 (VPOS)
unnamed: C4.2, R3.1, U1.4 (VPOS)
unnamed: C2.2, R2.1, U1.2 (INHI)
unnamed: C3.2, R2.2, U1.3 (INLO)
unnamed: R4.1, Rprot1.1, U1.8 (VOUT)
unnamed: R4.2, U1.7 (VSET)

Notes on the sheet:
Démodulateur ASK - AD8313
Port d'alimentation VCC
Port SMA

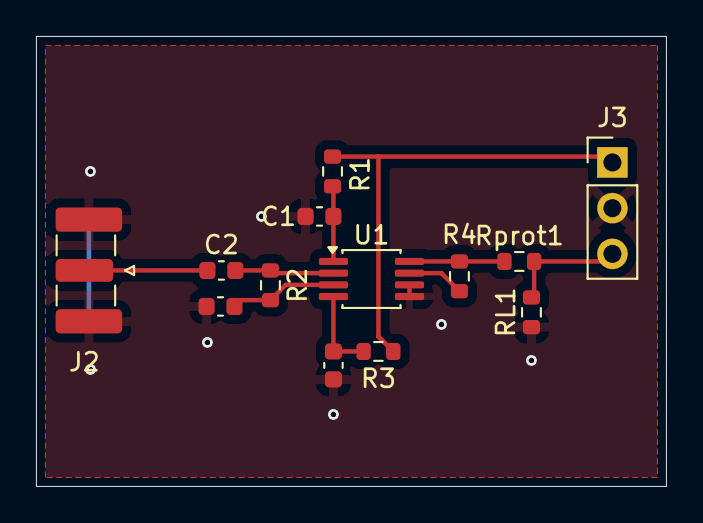
[picture p63: board Démodulateur USART ASK.kicad_pcb from above]

Board: 2 copper layers, 35.0 x 25.0 mm, 13 parts (0 on the bottom side), 10 nets.
