azerty220/usart_sans_fil_projet_esc2026_2027/PCB1/pa_filtrage/pa_filtrage/pa_filtrage.kicad_pcb

## KiCad design PCB1/pa_filtrage/pa_filtrage/pa_filtrage.kicad_pcb (2026-10-22)

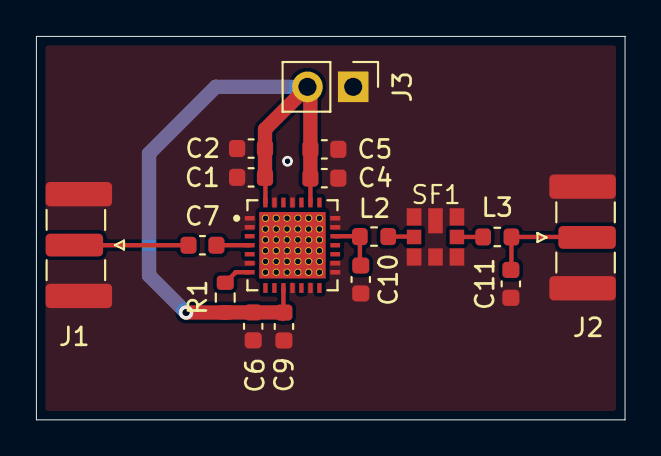
[picture p64: board pa_filtrage.kicad_pcb from above]

Board: 2 copper layers, 32.7 x 21.3 mm, 17 parts (0 on the bottom side), 9 nets.

Parts:
C1, C4, C6, C9: 0.1u; C_0603_1608Metric
C2, C5: 10u; C_0603_1608Metric
C7: 33p; C_0603_1608Metric
C10: 2.7p; C_0603_1608Metric
C11: 3.5p; C_0603_1608Metric
J1, J2: Conn_Coaxial; SMA_Samtec_SMA-J-P-H-ST-EM1_EdgeMount
J3: Conn_01x02_Pin; PinHeader_1x02_P2.54mm_Vertical
L2, L3: 24n; L_0603_1608Metric
R1: 5k1; R_0603_1608Metric
SF1: SF2425E
U1: SKY66185-11; IC_SKY66185-11

Connections:
+3.3V: C1.2, C2.2, C4.1, C5.1, C6.2, C9.1, J3.2, R1.1, U1.10 (VBIAS), U1.23 (VCC3), U1.28 (VCC1)
FiltreIN: C10.1, L2.1, U1.19 (RFOUT)
FiltreOUT: C11.1, J2.1 (In), L3.2
GND: C1.1, C2.1, C4.2, C5.2, C6.1, C9.2, C10.2, C11.2, J1.2 (Ext), J2.2 (Ext), J3.1, SF1.1 (IN_GND), SF1.3 (GND), SF1.4 (GND), SF1.5 (OUT_GND), SF1.7 (GND), SF1.8 (GND), U1.1 (GND), U1.2 (GND), U1.6 (GND), U1.11 (GND), U1.13 (GND), U1.15 (GND), U1.16 (GND), U1.20 (GND), U1.21 (GND), U1.25 (GND), U1.27 (GND)
unnamed: L2.2, SF1.2 (IN)
unnamed: L3.1, SF1.6 (OUT)
unnamed: C7.2, U1.4 (RFIN)
unnamed: R1.2, U1.7 (~VEN)
RFIN: C7.1, J1.1 (In)
