azerty220/usart_sans_fil_projet_esc2026_2027/PCB1/ASK_Mod+PLL_Oscill/ASK_Mod+PLL_Oscill.kicad_pcb

## KiCad design PCB1/ASK_Mod+PLL_Oscill/ASK_Mod+PLL_Oscill.kicad_pcb (2026-10-20)

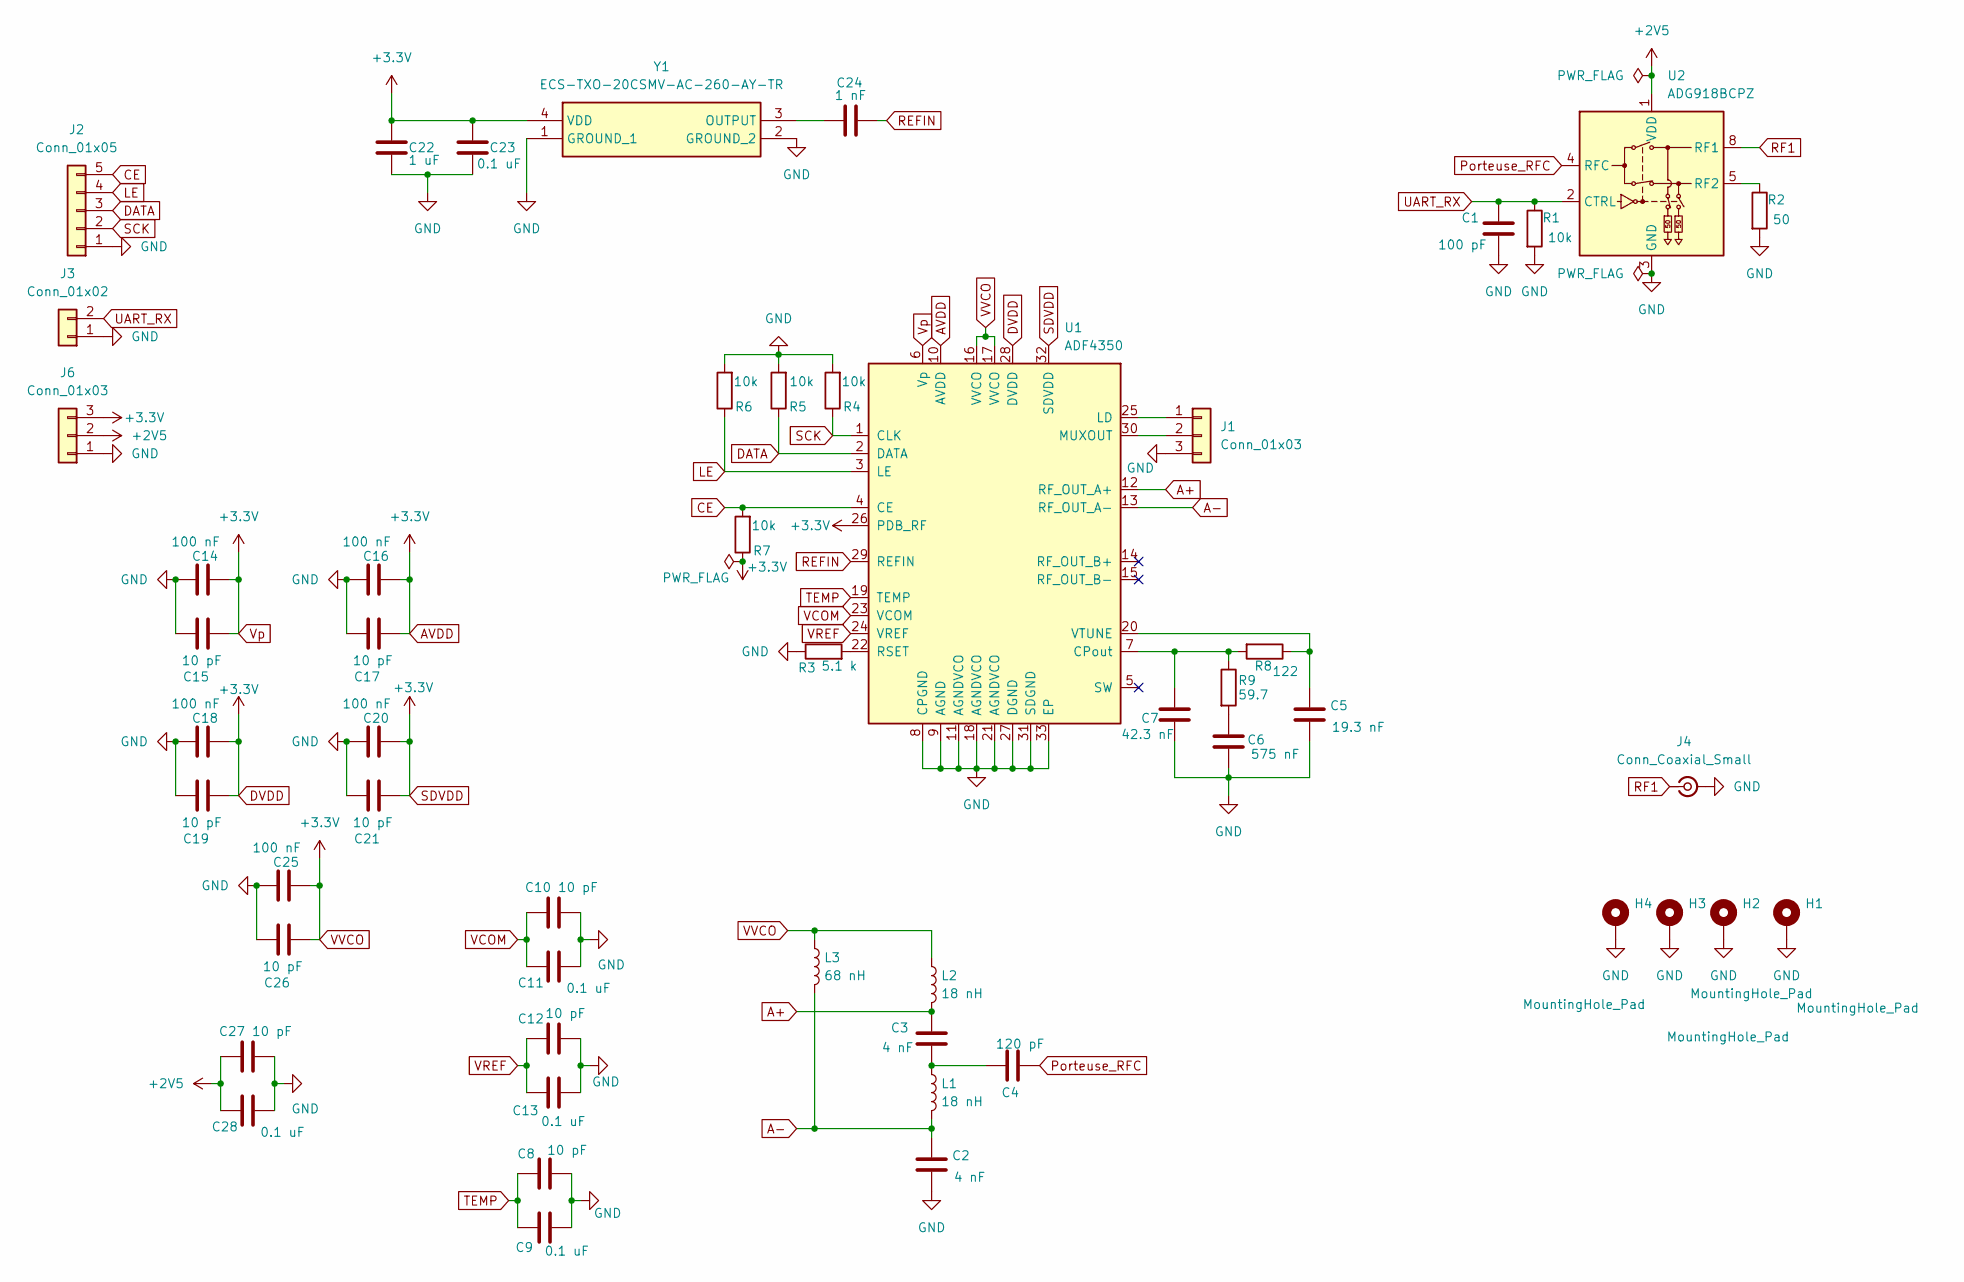
[picture p65: schematic ASK_Mod+PLL_Oscill.kicad_sch, Modulateur ASK (Commutateur RF) et génération de porteuse]

Parts:
C1: 100 pF; C_0603_1608Metric_Pad1.08x0.95mm_HandSolder
C2, C3: 4 nF; C_0603_1608Metric_Pad1.08x0.95mm_HandSolder
C4: 120 pF; C_0603_1608Metric_Pad1.08x0.95mm_HandSolder
C5: 19.3 nF; C_0603_1608Metric_Pad1.08x0.95mm_HandSolder
C6: 575 nF; C_0603_1608Metric_Pad1.08x0.95mm_HandSolder
C7: 42.3 nF; C_0603_1608Metric_Pad1.08x0.95mm_HandSolder
C8, C10, C12, C15, C17, C19, C21, C26, C27: 10 pF; C_0603_1608Metric_Pad1.08x0.95mm_HandSolder
C9, C11, C13, C23, C28: 0.1 uF; C_0603_1608Metric_Pad1.08x0.95mm_HandSolder
C14, C16, C18, C20, C25: 100 nF; C_0603_1608Metric_Pad1.08x0.95mm_HandSolder
C22: 1 uF; C_0603_1608Metric_Pad1.08x0.95mm_HandSolder
C24: 1 nF; C_0603_1608Metric_Pad1.08x0.95mm_HandSolder
H1, H2, H3, H4: MountingHole_Pad; MountingHole_3.2mm_M3_Pad
J1, J6: Conn_01x03; PinHeader_1x03_P2.54mm_Vertical
J2: Conn_01x05; PinHeader_1x05_P2.54mm_Vertical
J3: Conn_01x02; PinHeader_1x02_P2.54mm_Vertical
J4: Conn_Coaxial_Small; SMA_Samtec_SMA-J-P-H-ST-EM1_EdgeMount
L1, L2: 18 nH; L_0402_1005Metric_Pad0.77x0.64mm_HandSolder
L3: 68 nH; L_0402_1005Metric_Pad0.77x0.64mm_HandSolder
R1, R4, R5, R6, R7: 10k; R_0603_1608Metric_Pad0.98x0.95mm_HandSolder
R2: 50; R_0603_1608Metric_Pad0.98x0.95mm_HandSolder
R3: 5.1 k; R_0603_1608Metric_Pad0.98x0.95mm_HandSolder
R8: 122; R_0603_1608Metric_Pad0.98x0.95mm_HandSolder
R9: 59.7; R_0603_1608Metric_Pad0.98x0.95mm_HandSolder
U1: ADF4350; LFCSP-32-1EP_5x5mm_P0.5mm_EP3.25x3.25mm
U2: ADG918BCPZ; LFCSP-8-1EP_3x3mm_P0.5mm_EP1.45x1.74mm
Y1: ECS-TXO-20CSMV-AC-260-AY-TR; Oscillator_SMD_SiT_PQFN-4Pin_2.0x1.6mm; Mouser Part Number 520-T20CSMVAC260AYTR

Connections:
+2V5: C27.1, C28.1, J6.2, U2.1 (VDD)
A+: C3.1, L2.2, U1.12 (RF_OUT_A+)
A-: C2.1, L1.2, L3.2, U1.13 (RF_OUT_A-)
AVDD: C14.2, C15.2, C16.2, C17.2, C18.2, C19.2, C20.2, C21.2, C22.1, C23.1, C25.2, C26.2, J6.3, L2.1, L3.1, R7.1, U1.6 (Vp), U1.10 (AVDD), U1.16 (VVCO), U1.17 (VVCO), U1.26 (PDB_RF), U1.28 (DVDD), U1.32 (SDVDD), Y1.4 (VDD)
CE: J2.5, R7.2, U1.4 (CE)
DATA: J2.3, R5.1, U1.2 (DATA)
GND: C1.2, C2.2, C5.2, C6.2, C7.2, C8.2, C9.2, C10.2, C11.2, C12.2, C13.2, C14.1, C15.1, C16.1, C17.1, C18.1, C19.1, C20.1, C21.1, C22.2, C23.2, C25.1, C26.1, C27.2, C28.2, H1.1, H2.1, H3.1, H4.1, J1.3, J2.1, J3.1, J4.2 (Ext), J6.1, R1.2, R2.2, R3.1, R4.2, R5.2, R6.2, U1.8 (CPGND), U1.9 (AGND), U1.11 (AGNDVCO), U1.18 (AGNDVCO), U1.21 (AGNDVCO), U1.27 (DGND), U1.31 (SDGND), U1.33 (EP), U2.3 (GND), U2.6 (GND), U2.7 (GND), U2.9 (GND), Y1.1 (GROUND_1), Y1.2 (GROUND_2)
LE: J2.4, R6.1, U1.3 (LE)
unnamed: C3.2, C4.1, L1.1
unnamed: C6.1, R9.2
unnamed: J1.1, U1.25 (LD)
unnamed: J1.2, U1.30 (MUXOUT)
unnamed: C7.1, R8.2, R9.1, U1.7 (CPout)
unnamed: R3.2, U1.22 (RSET)
unnamed: C5.1, R8.1, U1.20 (VTUNE)
unnamed: R2.1, U2.5 (RF2)
unnamed: C24.1, Y1.3 (OUTPUT)
Porteuse_RFC: C4.2, U2.4 (RFC)
REFIN: C24.2, U1.29 (REFIN)
RF1: J4.1 (In), U2.8 (RF1)
SCK: J2.2, R4.1, U1.1 (CLK)
TEMP: C8.1, C9.1, U1.19 (TEMP)
UART_RX: C1.1, J3.2, R1.1, U2.2 (CTRL)
VCOM: C10.1, C11.1, U1.23 (VCOM)
VREF: C12.1, C13.1, U1.24 (VREF)

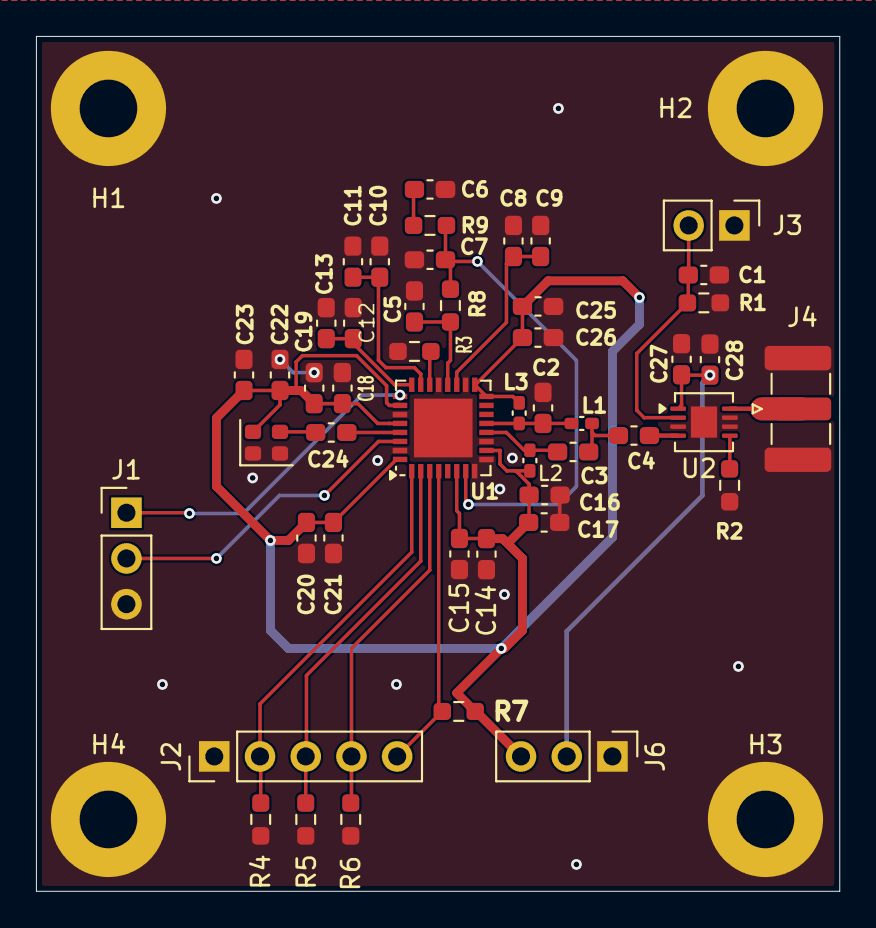
[picture p66: board ASK_Mod+PLL_Oscill.kicad_pcb from above]

Board: 2 copper layers, 44.6 x 47.5 mm, 52 parts (0 on the bottom side), 25 nets.
