azerty220/usart_sans_fil_projet_esc2026_2027/PCB1/antenne_switch/switch_antenne_pcb_projet.kicad_pcb

## KiCad design PCB1/antenne_switch/switch_antenne_pcb_projet.kicad_pcb (2026-10-18)

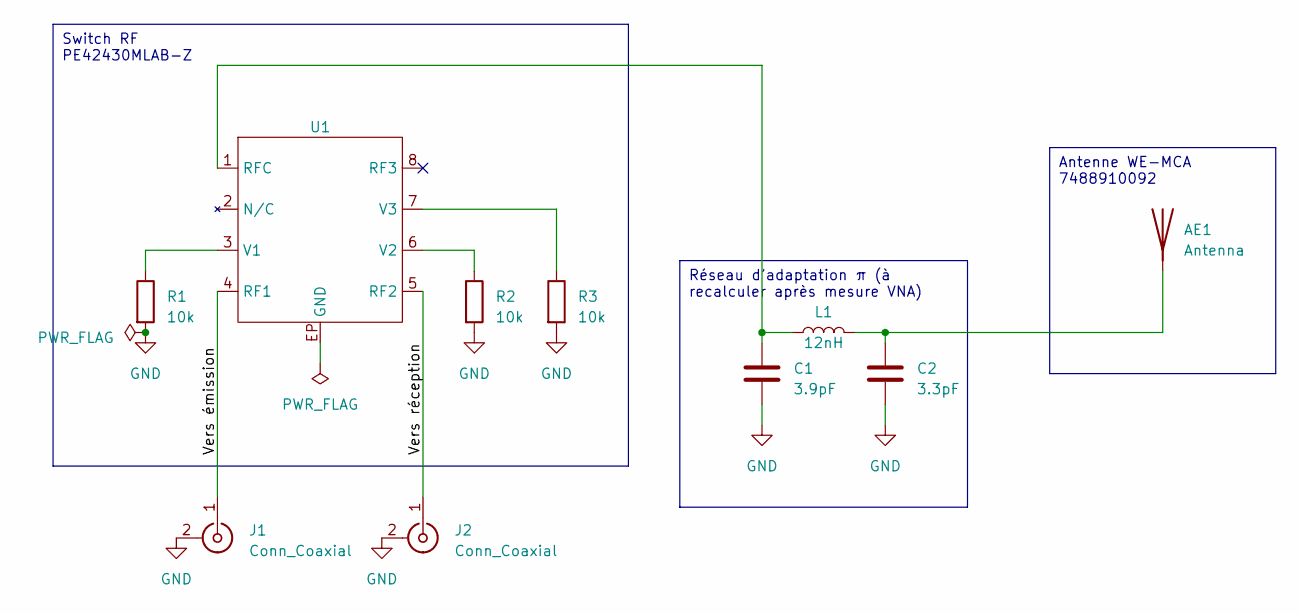
[picture p67: schematic switch_antenne_pcb_projet.kicad_sch]

Parts:
AE1: Antenna; AE_Wurth_WE-MCA_7488910092
C1: 3.9pF; C_0402_1005Metric_Pad0.74x0.62mm_HandSolder
C2: 3.3pF; C_0402_1005Metric_Pad0.74x0.62mm_HandSolder
J1, J2: Conn_Coaxial; SMA_Samtec_SMA-J-P-X-ST-EM1_EdgeMount
L1: 12nH; L_0402_1005Metric_Pad0.77x0.64mm_HandSolder
R1, R2, R3: 10k; R_0603_1608Metric_Pad0.98x0.95mm_HandSolder
U1: SON50P200X200X60-9N160X90

Connections:
/Vers réception: J2.1 (In), U1.5 (RF2)
/Vers émission: J1.1 (In), U1.4 (RF1)
GND: C1.2, C2.2, J1.2 (Ext), J2.2 (Ext), R1.2, R2.2, R3.2
unnamed: AE1.2 (A), C2.1, L1.2
unnamed: C1.1, L1.1, U1.1 (RFC)
unnamed: R1.1, U1.3 (V1)
unnamed: R2.1, U1.6 (V2)
unnamed: R3.1, U1.7 (V3)

Notes on the sheet:
Switch RF PE42430MLAB-Z
Réseau d’adaptation π (à recalculer après mesure VNA)
Antenne WE-MCA 7488910092

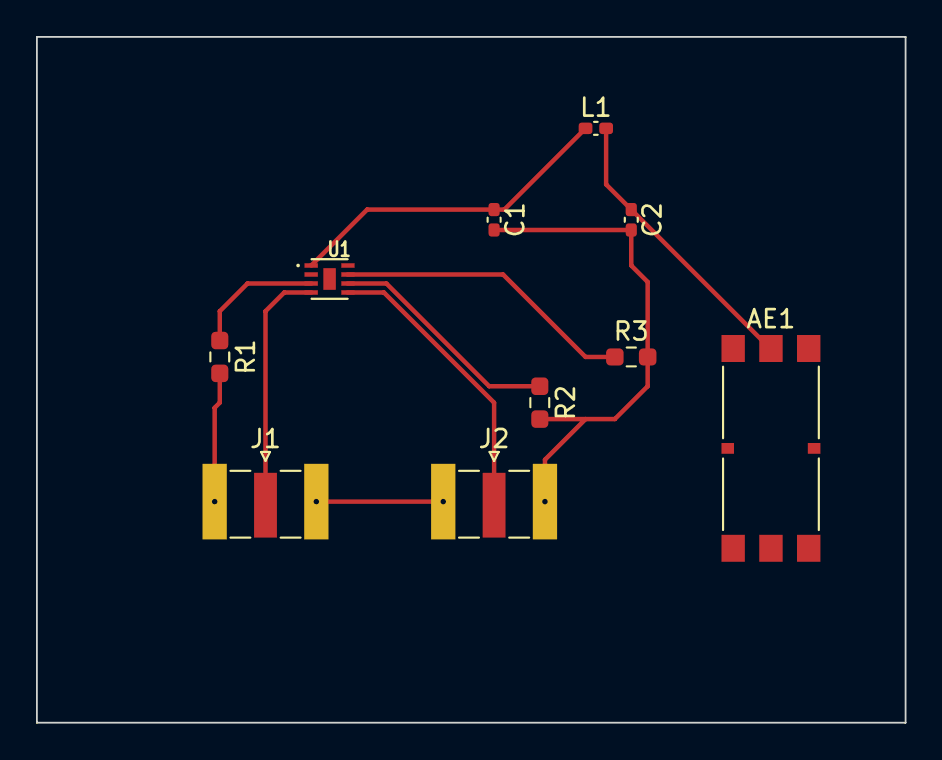
[picture p68: board switch_antenne_pcb_projet.kicad_pcb from above]

Board: 2 copper layers, 48.3 x 38.1 mm, 10 parts (0 on the bottom side), 8 nets.
