azerty220/usart_sans_fil_projet_esc2026_2027/(commit log)

2026-10-08 composant projet
    [liste_composants_projet.ods]
2026-10-15 Datasheet and EDA files for SAW filter
    Added datasheet for Murata SF2425E and Kicad symbol / footprint
2026-10-15 Datasheet and EDA files for PA
    Added datasheet for SKY66185 and Kicad symbol / footprint
2026-10-15 Updated solder mask
    Updated solder mask on SF2425 footprint
2026-10-15 Create gitignore
    Pensez à ajouter les fichiers que vous ne voulez pas sur le git ici
2026-10-15 added kicad lockfile to gitignore
2026-10-15 PCB1 fini à valider
2026-10-15 Correction footprints SKY à jour
2026-10-15 Updated edge cut
2026-10-16 PCB Demod
2026-10-22 Final modifications PCB 1 pa-filtrage
2026-10-22 PCB_LNA/Filtre
    Ajout du premier PCB LNA/Filtre (Rafif, Julie L)
2026-10-22 Conversion to Kicad 9.0
2026-10-29 Enhance README with emission chain details
    Added detailed description of the emission chain objectives and functionality.
2026-10-29 Improve formatting of emission chain objectives
    Reformatted the objectives of the emission chain for better readability by adding line breaks.
2026-10-30 Update README with emission chain details and assignments
    Correct formatting and add team member assignments in the emission chain description.
2026-10-30 Update README with PCB overview and RF switch section
2026-11-05 gros pcb routage en cours 16 erreurs DRC
2026-11-05 routage gros PCB 0 erreur DRC
2026-11-12 version ENVOYEE du gros pcb numero 1
2026-11-12 gerber gros pcb version 1
